etrautmann/Neuropixels-NHP-hardware/docs/images/Narishige_1.png

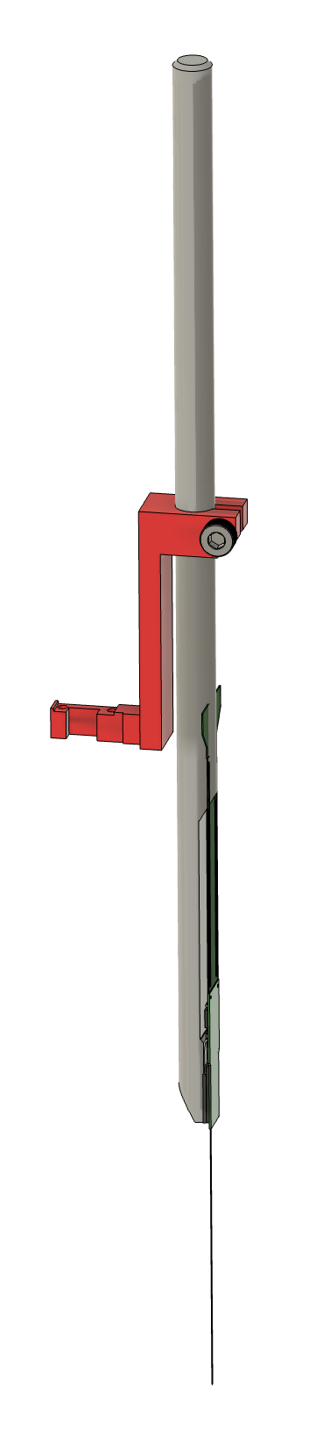
docs/images/Narishige_1.png
