etrautmann/Neuropixels-NHP-hardware/docs/images/Narishige_2.png

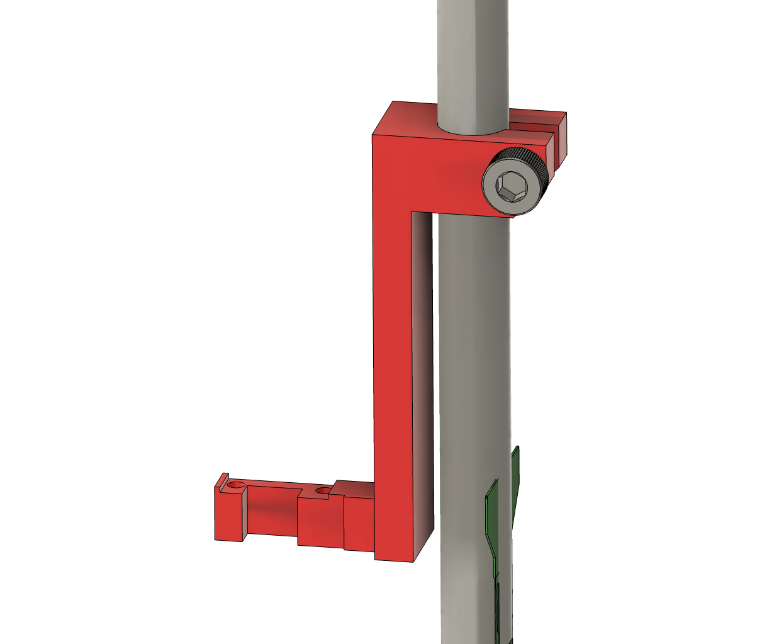
docs/images/Narishige_2.png
