etrautmann/Neuropixels-NHP-hardware/example insertion systems/adapters for commercial drives/NAN drive adapter/NAN dovetail rod mount - concept 2.png

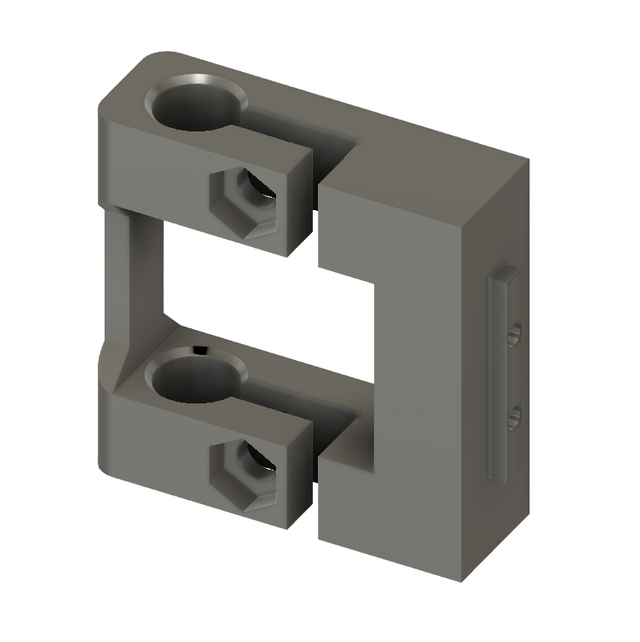
example insertion systems/adapters for commercial drives/NAN drive adapter/NAN dovetail rod mount - concept 2.png
