etrautmann/Neuropixels-NHP-hardware/example insertion systems/linear rail system/example 2 (subj. I)/Igor grid rendering - 3x probes.JPEG

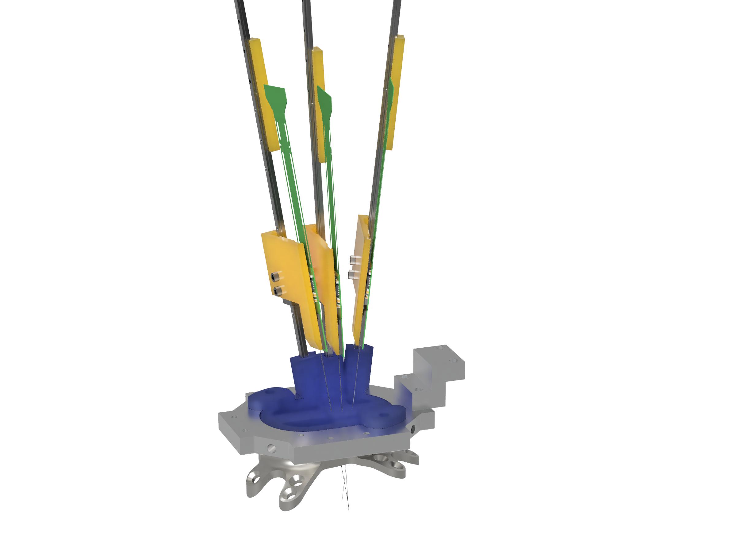
example insertion systems/linear rail system/example 2 (subj. I)/Igor grid rendering - 3x probes.JPEG
