etrautmann/Neuropixels-NHP-hardware/example insertion systems/linear rail system/linear rail components/linear rail probe adapter/readme.md

- Used with 2mm linear guide rail: 

McMaster product: https://www.mcmaster.com/8381K2/

Mounting screws: https://www.mcmaster.com/91292A328/

Set screws for attaching 2mm rail to 3D printed base: https://www.mcmaster.com/92605A043/
