etrautmann/Neuropixels-NHP-hardware/example insertion systems/linear rail system/linear rail components/linear rail probe adapter/Screen Shot 2022-10-31 at 12.18.04 PM.png

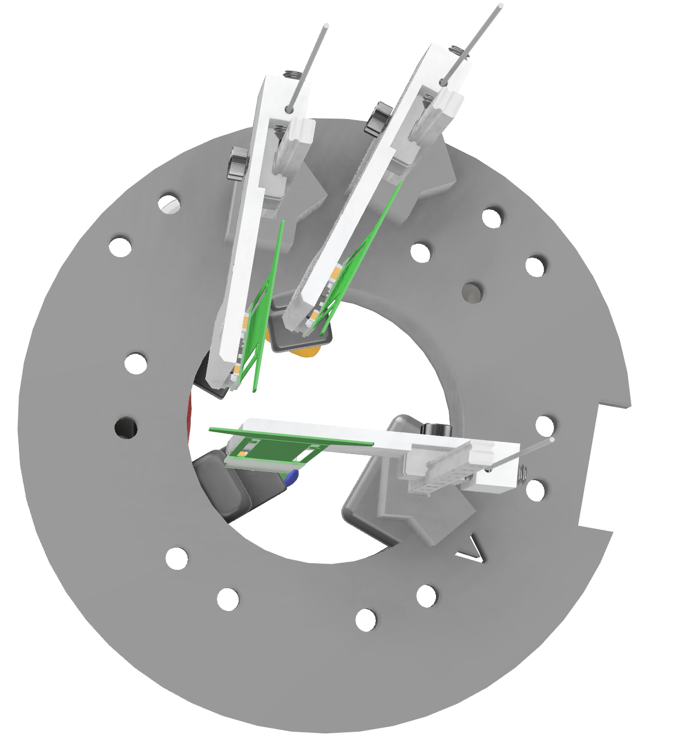
example insertion systems/linear rail system/linear rail components/linear rail probe adapter/Screen Shot 2022-10-31 at 12.18.04 PM.png
