etrautmann/Neuropixels-NHP-hardware/cad models/Neuropixels NHP 25 mm/Neuropixels NHP - 25 mm.step

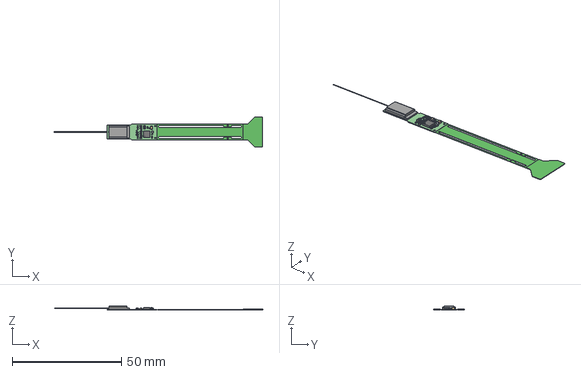
[picture p12: CAD file, 2022-11-23]
cad models/Neuropixels NHP 25 mm/Neuropixels NHP - 25 mm.step
95.4 x 13.8 x 1.75 mm
