etrautmann/Neuropixels-NHP-hardware/cad models/Neuropixels NHP 45 mm/Neuropixels NHP - 45 mm.step

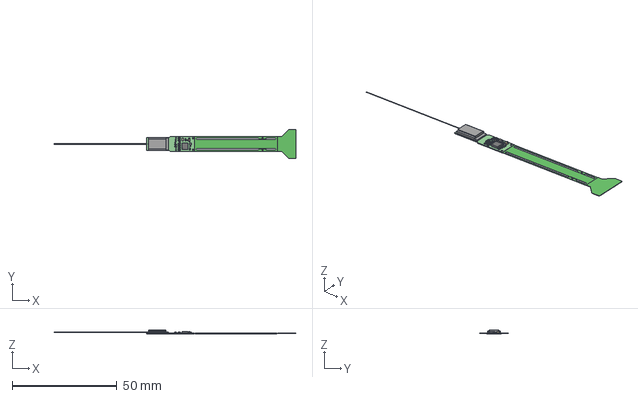
[picture p13: CAD file, 2022-11-23]
cad models/Neuropixels NHP 45 mm/Neuropixels NHP - 45 mm.step
115.5 x 13.8 x 1.75 mm
