etrautmann/Neuropixels-NHP-hardware/cad models/Neuropixels v1 10 mm/Neuropixels V1 - 10 mmm.step

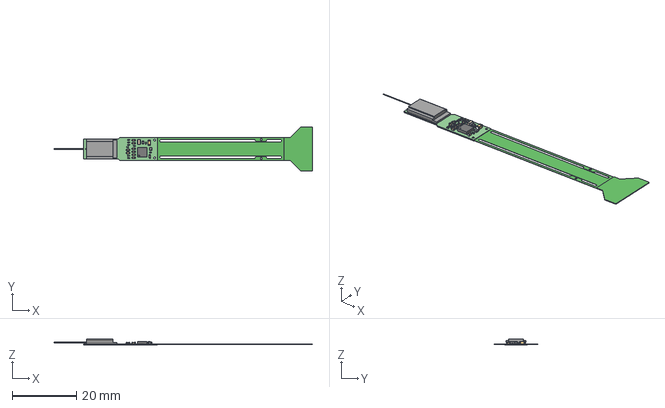
[picture p14: CAD file, 2022-11-23]
cad models/Neuropixels v1 10 mm/Neuropixels V1 - 10 mmm.step
80.4 x 13.8 x 1.75 mm
