etrautmann/Neuropixels-NHP-hardware/example insertion systems/adapters for commercial drives/MEM drive adapter/dovetail stabilizer.stp

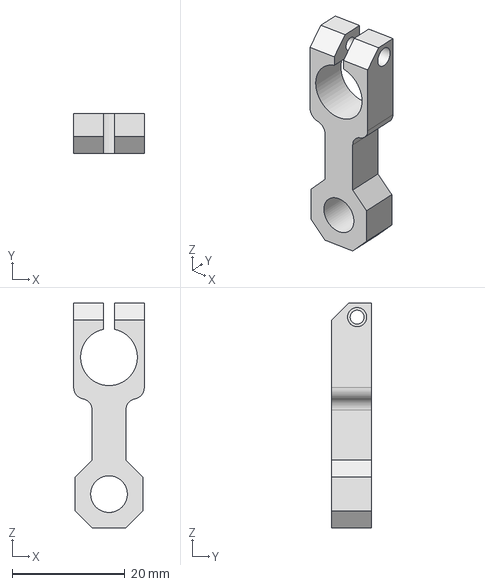
[picture p15: CAD file, 2023-09-12]
example insertion systems/adapters for commercial drives/MEM drive adapter/dovetail stabilizer.stp
12.5 x 7.00 x 39.8 mm
