etrautmann/Neuropixels-NHP-hardware/example insertion systems/adapters for commercial drives/NAN drive adapter/NAN tower v1.stl

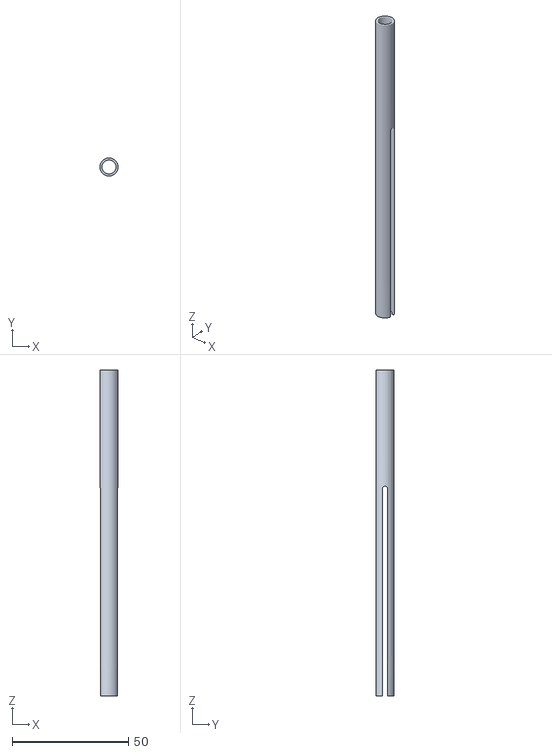
[picture p16: CAD file, 2023-04-04]
example insertion systems/adapters for commercial drives/NAN drive adapter/NAN tower v1.stl
7.80 x 7.76 x 140.0
