etrautmann/Neuropixels-NHP-hardware/example insertion systems/adapters for commercial drives/Narishige drive adapter/Narishige to dovetail rod adapter/Narishige to dovetail rod adapter - v5 - direct mount v1.step

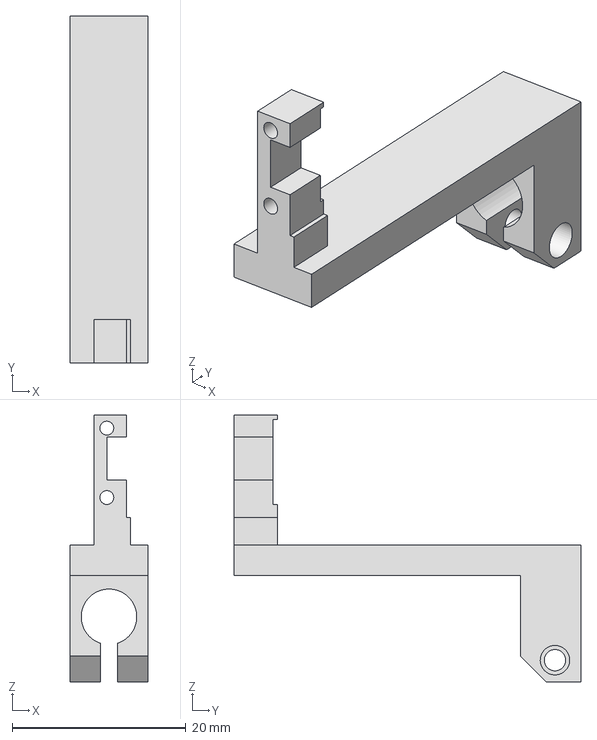
[picture p17: CAD file, 2022-10-01]
example insertion systems/adapters for commercial drives/Narishige drive adapter/Narishige to dovetail rod adapter/Narishige to dovetail rod adapter - v5 - direct mount v1.step
9.00 x 40.0 x 30.8 mm
