etrautmann/Neuropixels-NHP-hardware/example insertion systems/linear rail system/example 2 (subj. I)/Igor Grid mk 2 - multi probe v79.stl

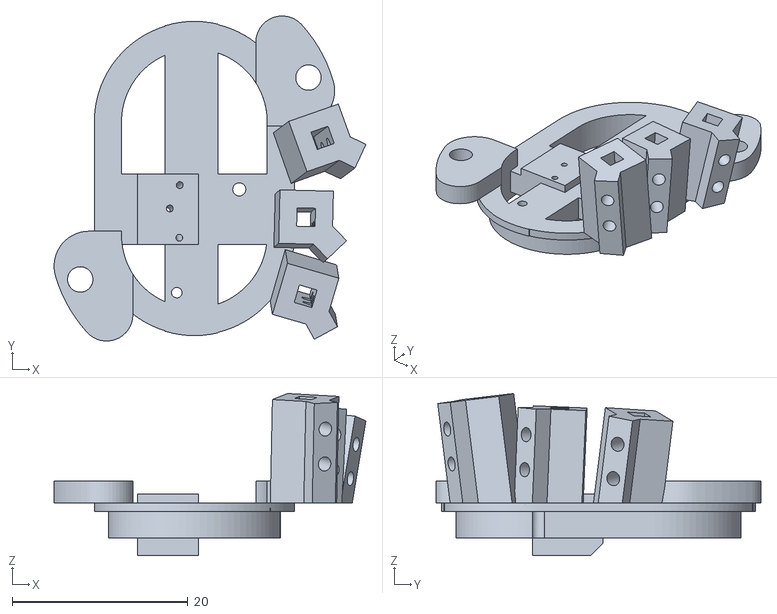
[picture p18: CAD file, 2022-10-31]
example insertion systems/linear rail system/example 2 (subj. I)/Igor Grid mk 2 - multi probe v79.stl
35.5 x 37.0 x 18.5
