etrautmann/Neuropixels-NHP-hardware/example insertion systems/linear rail system/linear rail components/IKO linear rail/2mm linear rail.step

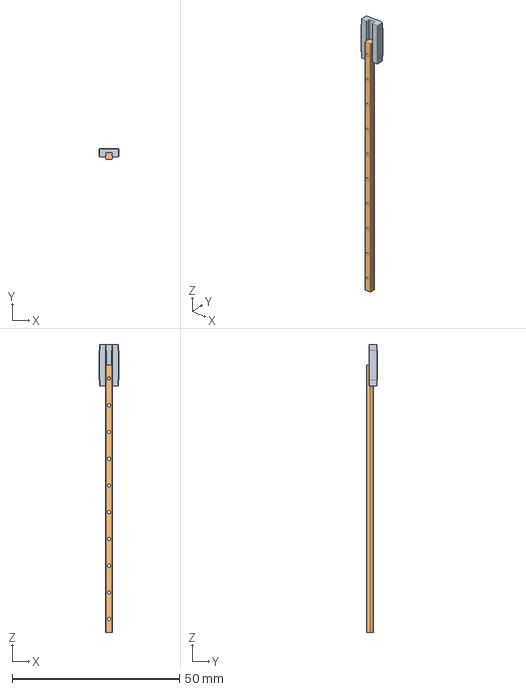
[picture p19: CAD file, 2022-12-16]
example insertion systems/linear rail system/linear rail components/IKO linear rail/2mm linear rail.step
6.00 x 3.20 x 86.2 mm
carriage
rail
