etrautmann/Neuropixels-NHP-hardware/example insertion systems/linear rail system/linear rail components/linear rail probe adapter/rail_NHP to 2mm rail adapter - long reach v39.step

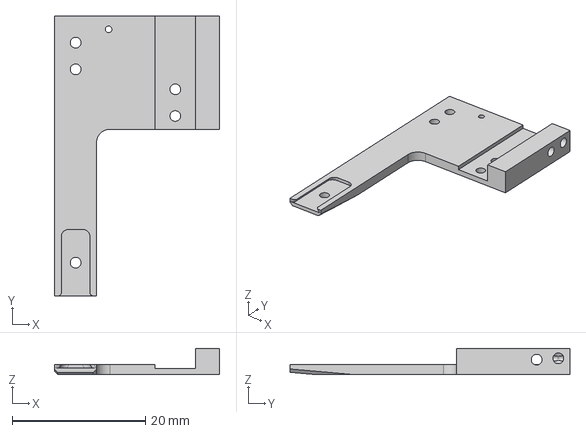
[picture p20: CAD file, 2022-12-16]
example insertion systems/linear rail system/linear rail components/linear rail probe adapter/rail_NHP to 2mm rail adapter - long reach v39.step
24.8 x 42.0 x 3.95 mm
