etrautmann/Neuropixels-NHP-hardware/example insertion systems/adapters for commercial drives/MEM drive adapter/MEM to dovetail rod adapter - v3 (1).stp

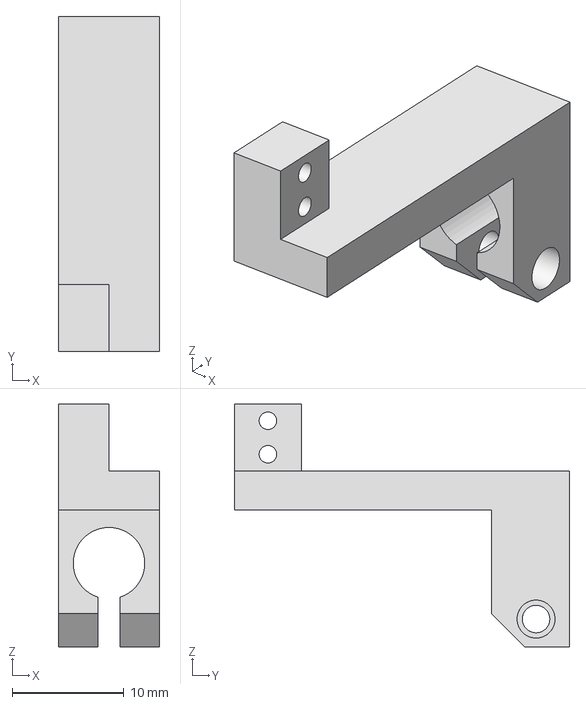
[picture p22: CAD file, 2022-11-04]
example insertion systems/adapters for commercial drives/MEM drive adapter/MEM to dovetail rod adapter - v3 (1).stp
9.00 x 30.0 x 21.8 mm
