etrautmann/Neuropixels-NHP-hardware/example insertion systems/adapters for commercial drives/NAN drive adapter/NAN dovetail rod mount - concept 2 v13.step

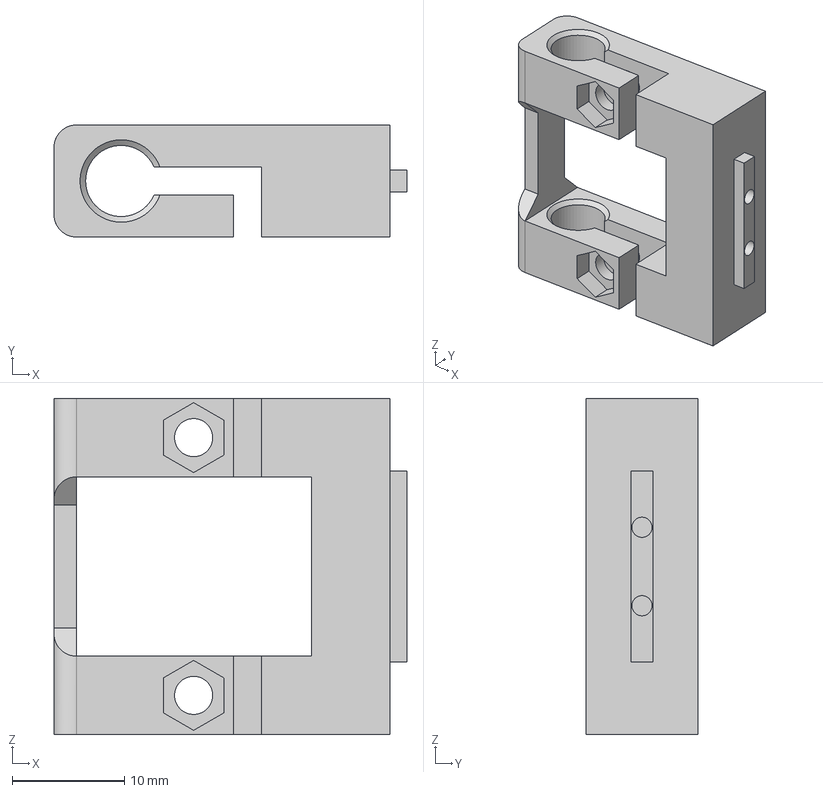
[picture p23: CAD file, 2022-10-01]
example insertion systems/adapters for commercial drives/NAN drive adapter/NAN dovetail rod mount - concept 2 v13.step
31.5 x 10.0 x 30.0 mm
