etrautmann/Neuropixels-NHP-hardware/example insertion systems/linear rail system/example 2 (subj. I)/Igor CHtR4.STL

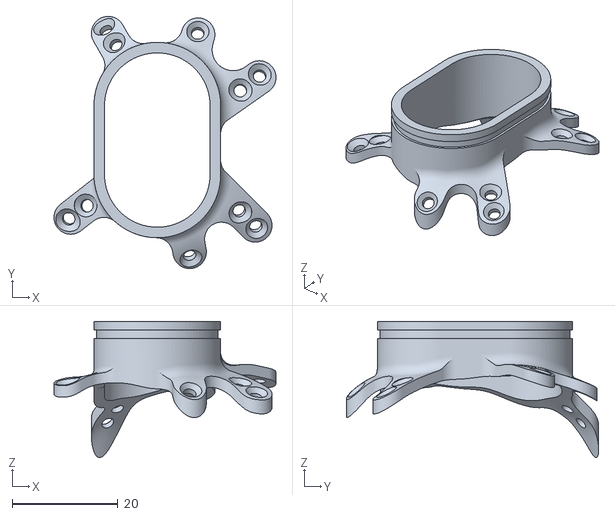
[picture p24: CAD file, 2022-10-31]
example insertion systems/linear rail system/example 2 (subj. I)/Igor CHtR4.STL
42.0 x 47.8 x 25.8
