etrautmann/Neuropixels-NHP-hardware/example insertion systems/adapters for commercial drives/Neuropixels dovetail rod/J007869 NEUROPIXELS DOVE TAIL MOUNT Rev -.stp

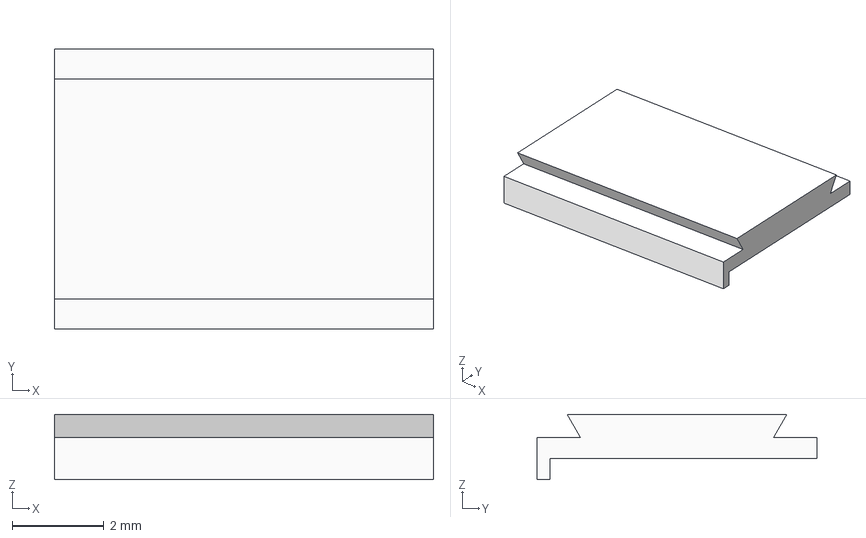
[picture p25: CAD file, 2022-10-01]
example insertion systems/adapters for commercial drives/Neuropixels dovetail rod/J007869 NEUROPIXELS DOVE TAIL MOUNT Rev -.stp
8.25 x 6.10 x 1.42 mm
