etrautmann/Neuropixels-NHP-hardware/example insertion systems/adapters for commercial drives/Neuropixels dovetail rod/J007778 NEUROPIXELS DOVE TAIL PROBE HOLDER Rev A.STP

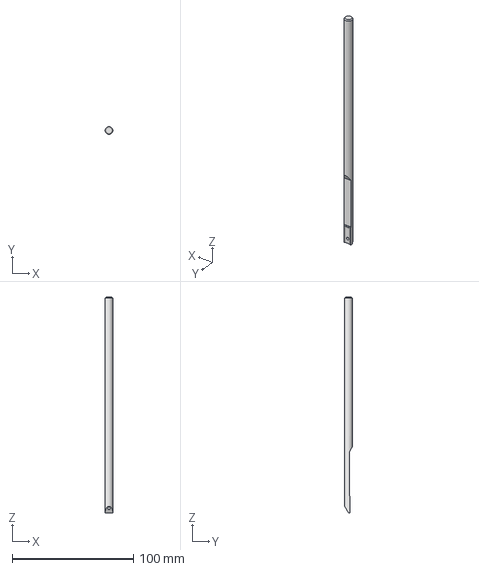
[picture p26: CAD file, 2022-10-01]
example insertion systems/adapters for commercial drives/Neuropixels dovetail rod/J007778 NEUROPIXELS DOVE TAIL PROBE HOLDER Rev A.STP
6.35 x 6.35 x 177.8 mm
