etrautmann/Neuropixels-NHP-hardware/(list of files, cad)

Other CAD files:
example insertion systems/linear rail system/linear rail components/IKO linear rail/2mm linear rail v16.stl
cad models/Neuropixels NHP 25 mm/Neuropixels NHP - 25 mm.f3d
cad models/Neuropixels NHP 25 mm/Neuropixels NHP - 25 mm.stl
cad models/Neuropixels NHP 45 mm/Neuropixels NHP - 45 mm.f3d
cad models/Neuropixels NHP 45 mm/Neuropixels NHP - 45 mm.stl
cad models/Neuropixels v1 10 mm/Neuropixels V1 - 10 mmm.f3d
cad models/Neuropixels v1 10 mm/Neuropixels V1 - 10 mmm.stl
cad models/headstage/Headstage - NP2_HS_00-04.f3d
example insertion systems/adapters for commercial drives/MEM drive adapter/MEM to dovetail rod adapter - v3 (1).ipt
example insertion systems/adapters for commercial drives/MEM drive adapter/dovetail stabilizer.ipt
example insertion systems/adapters for commercial drives/NAN drive adapter/NAN dovetail rod mount - concept 2 v13.f3d
example insertion systems/adapters for commercial drives/NAN drive adapter/NAN dovetail rod mount - concept 2 v13.iges
example insertion systems/adapters for commercial drives/NAN drive adapter/NAN dovetail rod mount - concept 2 v13.ipt
example insertion systems/adapters for commercial drives/NAN drive adapter/NAN tower v1.f3d
example insertion systems/adapters for commercial drives/NAN drive adapter/NAN tower v1.ipt
example insertion systems/adapters for commercial drives/Narishige drive adapter/Narishige to dovetail rod adapter/Narishige to dovetail rod adapter - v5 - direct mount v1.f3d
example insertion systems/adapters for commercial drives/Narishige drive adapter/Narishige to dovetail rod adapter/Narishige to dovetail rod adapter - v5 - direct mount v1.ipt
example insertion systems/adapters for commercial drives/Narishige drive adapter/Narishige to dovetail rod adapter/Narishige to dovetail rod adapter - v5 - direct mount v1.stl
example insertion systems/adapters for commercial drives/Neuropixels dovetail rod/J007778 NEUROPIXELS DOVE TAIL PROBE HOLDER Rev A.IPT
example insertion systems/adapters for commercial drives/Neuropixels dovetail rod/J007869 NEUROPIXELS DOVE TAIL MOUNT Rev -.ipt
example insertion systems/linear rail system/linear rail components/IKO linear rail/2mm linear rail v17.f3d
example insertion systems/linear rail system/linear rail components/rail connector mk 2/rail connector mk 2 - low profile v14.f3d
