etrautmann/Neuropixels-NHP-hardware/example insertion systems/linear rail system/linear rail components/linear rail probe adapter/rail_NHP to 2mm rail adapter - long reach Drawing v11.pdf

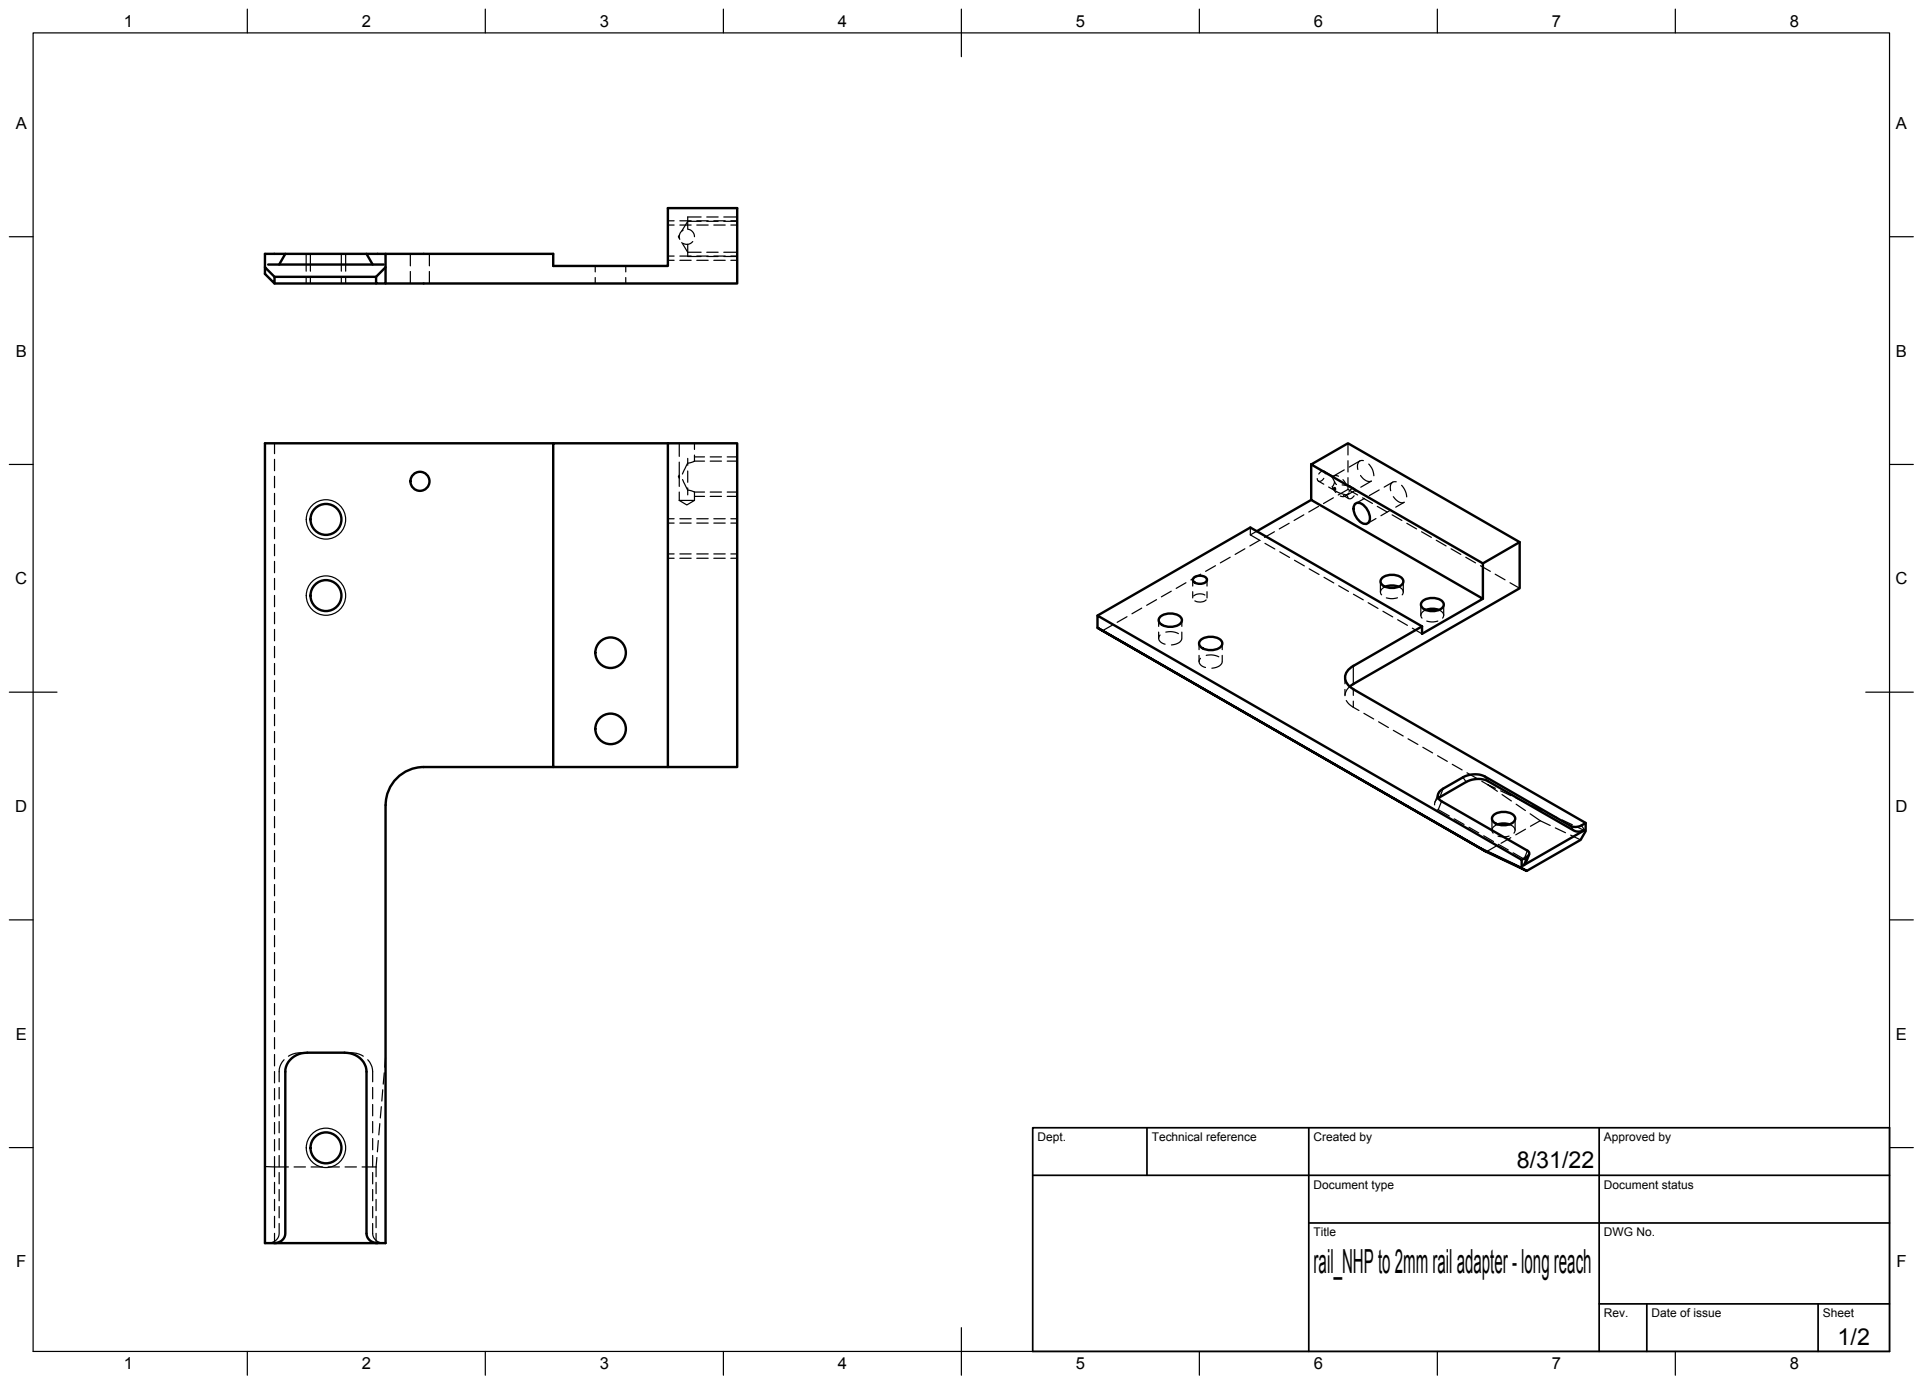
[picture p32: page 1]
Title; DWG No.; Rev.; Date of issue; Sheet

Dept. | Technical reference | Created by 8/31/22 | Approved by

Document type | Document status

rail_NHP to 2mm rail adapter - long reach

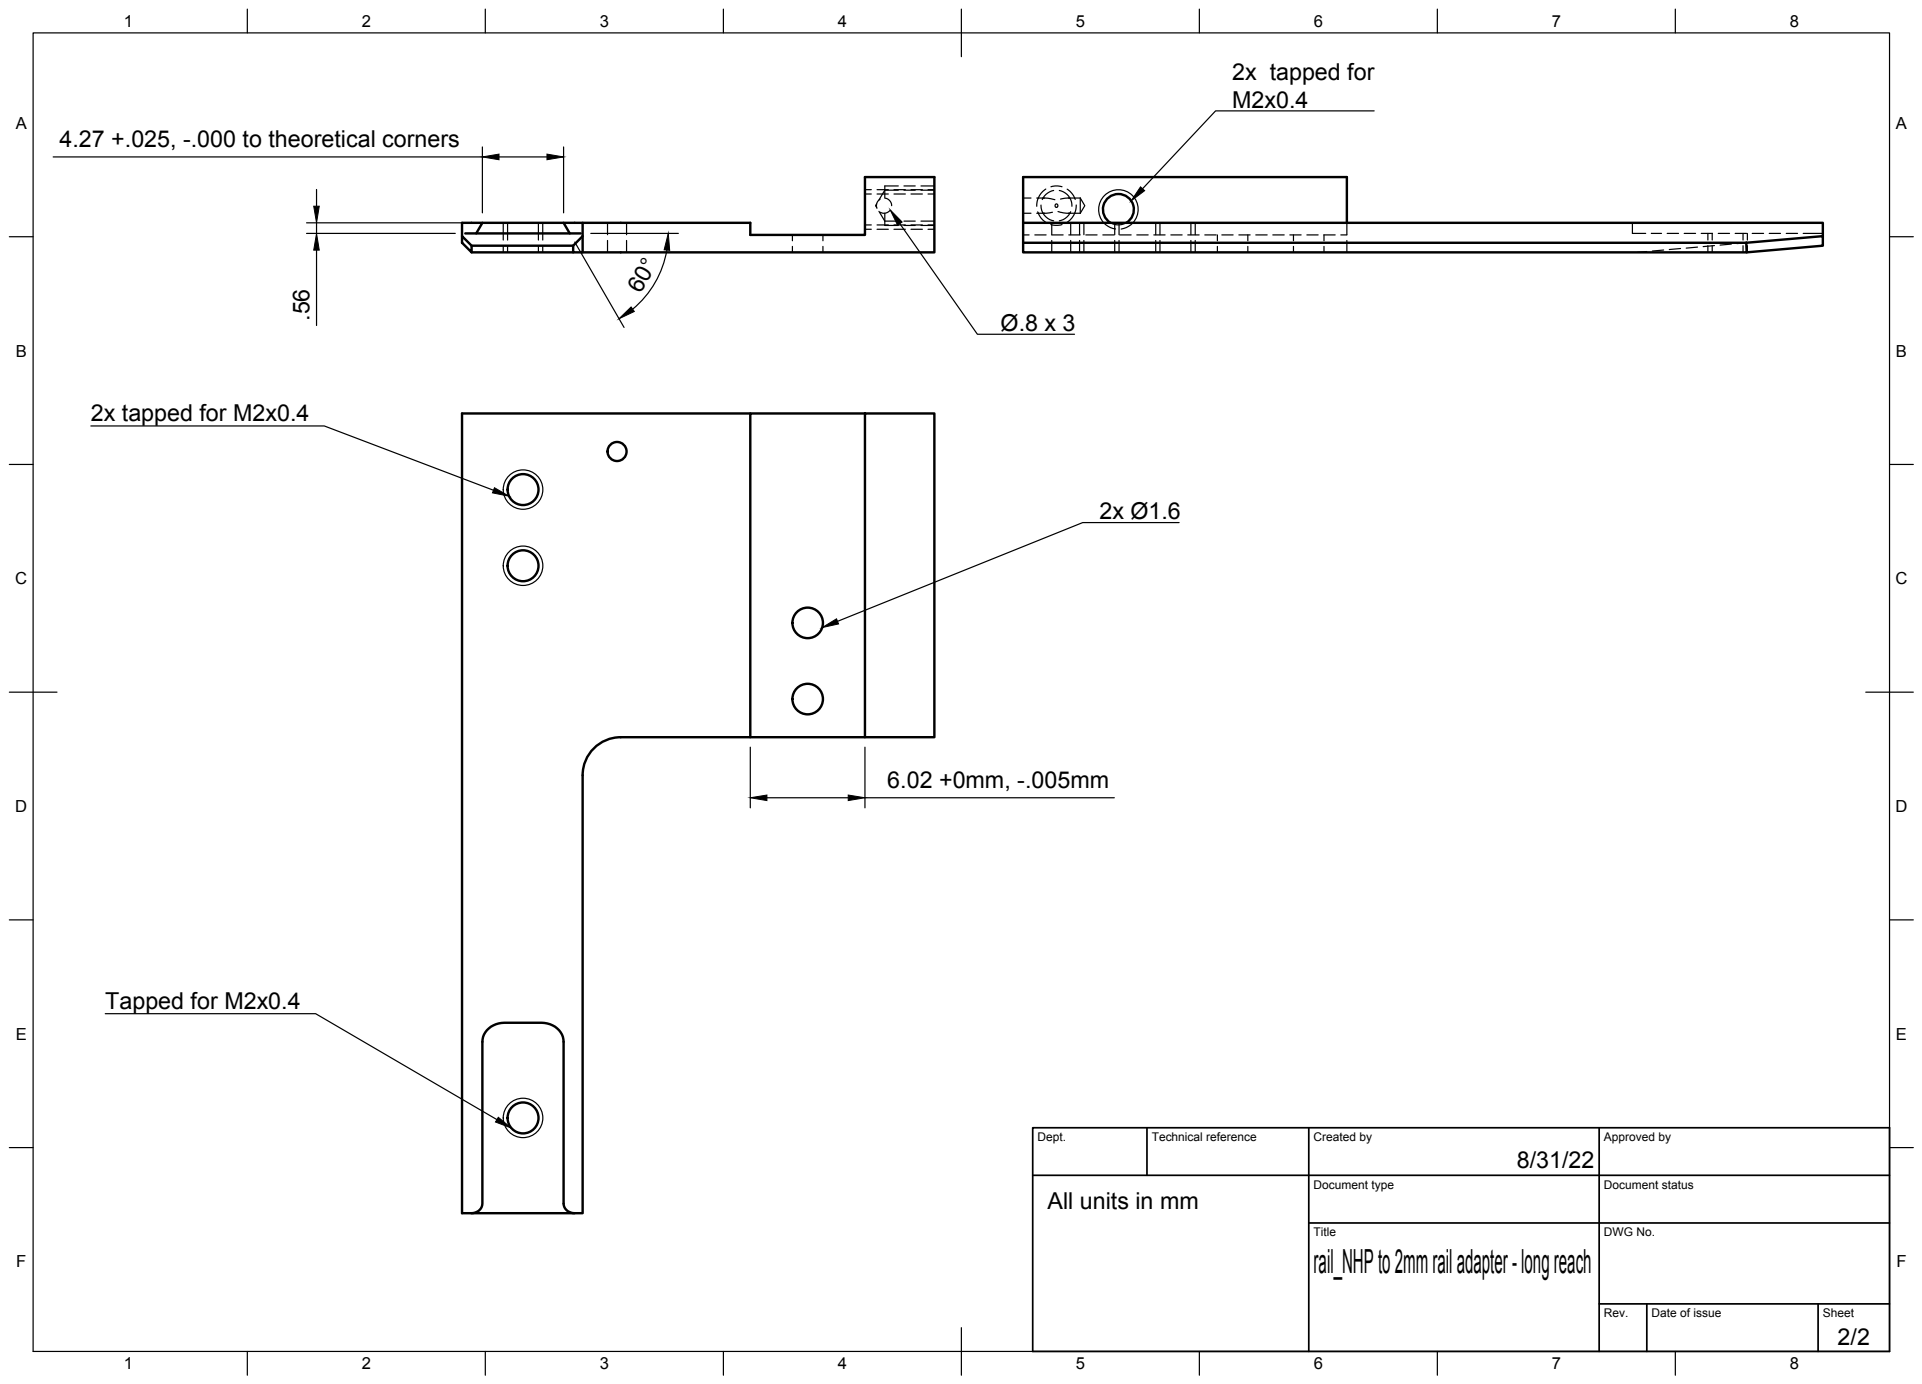
[picture p33: page 2]
Title; DWG No.; Rev.; Date of issue; Sheet; 2x tapped for M2x0.4; Tapped for M2x0.4; 2x tapped for

4.27 +.025, -.000 to theoretical corners .56

Dept. | Technical reference | Created by 8/31/22 | Approved by

Document type | Document status

All units in mm

rail_NHP to 2mm rail adapter - long reach
