etrautmann/Neuropixels-NHP-hardware/example insertion systems/adapters for commercial drives/Neuropixels dovetail rod/J007778 NEUROPIXELS DOVE TAIL PROBE HOLDER Rev A.PDF

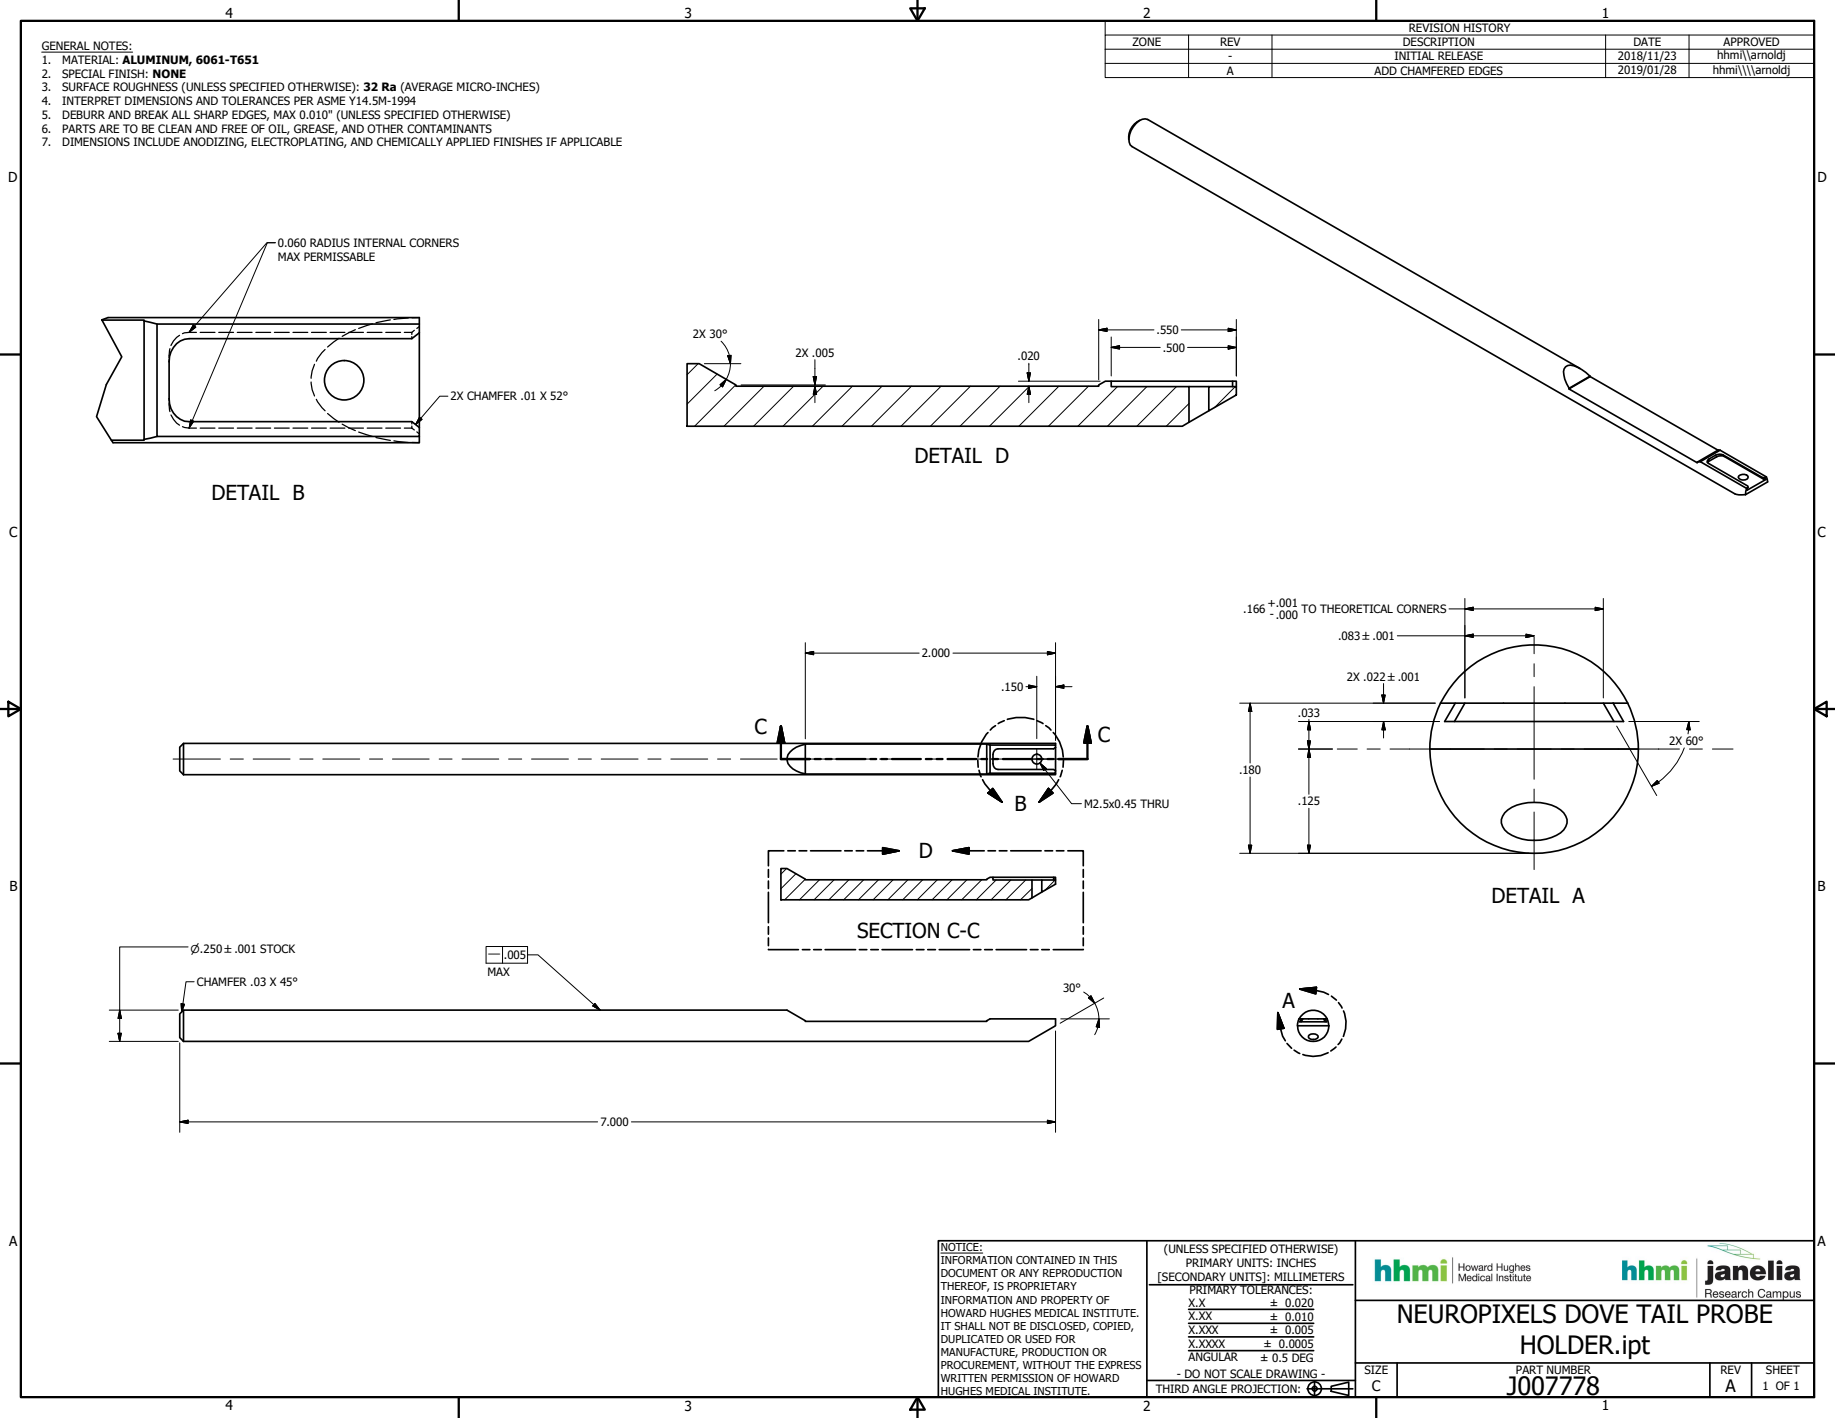
[picture p35: page 1]
DETAIL A; DETAIL B; SECTION C-C; DETAIL D; PART NUMBER; 1 OF 1 THIRD ANGLE PROJECTION:; ± 0.020 ± 0.010 ± 0.005 ± 0.0005 ± 0.5 DEG; REVISION HISTORY; M2.5x0.45 THRU; CHAMFER .03 X 45°; 2X CHAMFER .01 X 52°

GENERAL NOTES:
1. MATERIAL: ALUMINUM, 6061-T651
2. SPECIAL FINISH: NONE
3. SURFACE ROUGHNESS (UNLESS SPECIFIED OTHERWISE): 32 Ra (AVERAGE MICRO-INCHES)
4. INTERPRET DIMENSIONS AND TOLERANCES PER ASME Y14.5M-1994
5. DEBURR AND BREAK ALL SHARP EDGES, MAX 0.010" (UNLESS SPECIFIED OTHERWISE)
6. PARTS ARE TO BE CLEAN AND FREE OF OIL, GREASE, AND OTHER CONTAMINANTS
7. DIMENSIONS INCLUDE ANODIZING, ELECTROPLATING, AND CHEMICALLY APPLIED FINISHES IF APPLICABLE

ZONE | REV | DESCRIPTION | DATE | APPROVED

- | INITIAL RELEASE | 2018/11/23 | hhmi\\arnoldj
A | ADD CHAMFERED EDGES | 2019/01/28 | hhmi\\\\arnoldj

0.060 RADIUS INTERNAL CORNERS
MAX PERMISSABLE

TO THEORETICAL CORNERS

NOTICE:
INFORMATION CONTAINED IN THIS
DOCUMENT OR ANY REPRODUCTION
THEREOF, IS PROPRIETARY
INFORMATION AND PROPERTY OF
HOWARD HUGHES MEDICAL INSTITUTE.
IT SHALL NOT BE DISCLOSED, COPIED,
DUPLICATED OR USED FOR
MANUFACTURE, PRODUCTION OR
PROCUREMENT, WITHOUT THE EXPRESS
WRITTEN PERMISSION OF HOWARD
HUGHES MEDICAL INSTITUTE.

(UNLESS SPECIFIED OTHERWISE)
PRIMARY UNITS: INCHES
[SECONDARY UNITS]: MILLIMETERS
PRIMARY TOLERANCES:
X.XXX
X.XXXX
ANGULAR
- DO NOT SCALE DRAWING -

NEUROPIXELS DOVE TAIL PROBE
