etrautmann/Neuropixels-NHP-hardware/(commit log)

2022-10-01 Adding current drive adapter components for NAN, Narishige, linear rail, and dovetail rod
    [J007778 NEUROPIXELS DOVE TAIL PROBE HOLDER Rev A.IPT, J007778 NEUROPIXELS DOVE TAIL PROBE HOLDER Rev A.STP, J007869 NEUROPIXELS DOVE TAIL MOUNT Rev -.ipt, J007869 NEUROPIXELS DOVE TAIL MOUNT Rev -.stp, NAN dovetail rod mount - concept 2 v13.f3d, NAN dovetail rod mount - concept 2 v13.iges, NAN dovetail rod mount - concept 2 v13.ipt, NAN dovetail rod mount - concept 2 v13.step]
2022-10-31 added some hardware images
    [Igor CHtR4.STL, Igor Grid mk 2 - multi probe v79.stl]
2022-11-01 adding Tsao lab dovetail rail design files
    [Narishige to dovetail rod adapter - v5 - direct mount v1.f3d, Narishige to dovetail rod adapter - v5 - direct mount v1.ipt, Narishige to dovetail rod adapter - v5 - direct mount v1.step, Narishige to dovetail rod adapter - v5 - direct mount v1.stl, V-Probe_Simple_Adapter.SLDPRT, V-Probe_Simple_Adapter.STL, V-Probe_Simple_Adapter_SlightlyLonger_plus_15mm_depth_extra_extrude.SLDPRT, V-Probe_Simple_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]
2022-11-04 adding MEM mount and images
    [MEM to dovetail rod adapter - v3 (1).ipt, MEM to dovetail rod adapter - v3 (1).stp]
2022-11-23 adding headstage models
    [Headstage - NP2_HS_00-04.f3d]
2022-11-23 adding probe models
    [Neuropixels NHP - 25 mm.f3d, Neuropixels NHP - 25 mm.step, Neuropixels NHP - 25 mm.stl, Neuropixels NHP - 45 mm.f3d, Neuropixels NHP - 45 mm.step, Neuropixels NHP - 45 mm.stl]
2022-11-23 adding 10 mm probe
    [Neuropixels V1 - 10 mmm.f3d, Neuropixels V1 - 10 mmm.step, Neuropixels V1 - 10 mmm.stl]
2022-12-16 updated .gitignore
    [2mm linear rail v16.stl]
2022-12-16 major reorganization
    [2mm linear rail v17.f3d, 2mm linear rail.step, Headstage - NP2_HS_00-04.f3d, Igor CHtR4.STL, Igor Grid mk 2 - multi probe v79.stl, J007778 NEUROPIXELS DOVE TAIL PROBE HOLDER Rev A.IPT, J007778 NEUROPIXELS DOVE TAIL PROBE HOLDER Rev A.STP, J007869 NEUROPIXELS DOVE TAIL MOUNT Rev -.ipt]
2022-12-21 reorganization and updates to readme
    [Igor CHtR4.STL, Igor Grid mk 2 - multi probe v79.stl, rail_NHP to 2mm rail adapter - long reach v39.step]
2022-12-21 adding probe image
2023-04-04 reorg and adding mapfiles
    [Headstage - NP2_HS_00-04.f3d, Igor CHtR4.STL, Igor Grid mk 2 - multi probe v79.stl, NAN tower v1.f3d, NAN tower v1.ipt, NAN tower v1.stl, Narishige to dovetail rod adapter - v5 - direct mount v1.f3d, Narishige to dovetail rod adapter - v5 - direct mount v1.ipt]
2023-09-12 adding dovetail stabilizers for MEM drives
    [dovetail stabilizer.ipt, dovetail stabilizer.stp]
